Rodriguesmath/Pedaleira-digital/app/backend/README.md

# Backend




## Sobre

Serviço responsável por intermediar a comunicação entre o
[frontend](../frontend) e a pedaleira, publicando/assinando tópicos MQTT
consumidos pela [ESP32](../../firmware/esp32). Cuida de persistência de
presets, autenticação e demais regras de negócio da aplicação.

Ainda sem conteúdo.
