Rodriguesmath/Pedaleira-digital/firmware/esp32/README.md

# Firmware ESP32





## Sobre

Firmware responsável pela conectividade da pedaleira. Atua como ponte entre
a [STM32](../stm32), onde o áudio é processado, e uma aplicação externa
(mobile/desktop), via MQTT.

Recebe da aplicação as configurações de efeitos, equalização e demais
parâmetros, e repassa essas informações para a STM32 através da interface
de comunicação entre os dois microcontroladores.

## Status

Firmware ainda não iniciado.
