Rodriguesmath/Pedaleira-digital/docs/hardware/guia_esquematico_easyeda.md

# Guia Prático para Criação do Esquemático no EasyEDA Web





Este guia orienta passo a passo a montagem do esquemático elétrico do protótipo da **Pedaleira Digital** no [EasyEDA Web](https://easyeda.com/editor), utilizando componentes com encapsulamento **Through-Hole (DIP/THT)** ideais para montagem em protoboard e placa perfurada/ilhada, com seus respectivos códigos oficiais de catálogo **LCSC**.

---

## 1. Importação Direta do Arquivo JSON no EasyEDA Web (Recomendado)

O projeto disponibiliza o código-fonte nativo do esquemático em formato JSON padrão EasyEDA Standard em:
[`docs/hardware/pedaleira_digital_easyeda.json`](file:///home/rodrigues/Pedaleira-digital/docs/hardware/pedaleira_digital_easyeda.json).

Para abrir o esquemático pronto com 1 clique:
1. Acesse o editor web gratuito do EasyEDA: **[https://easyeda.com/editor](https://easyeda.com/editor)** (modo Standard).
2. No menu superior, clique em: **`File` $\to$ `Open` $\to$ `EasyEDA Source...`**
3. Clique em **`Load File`** e selecione o arquivo `pedaleira_digital_easyeda.json` (ou abra o arquivo de texto, copie todo o seu conteúdo JSON e cole na janela).
4. Clique no botão **`Apply`**.
5. O esquemático completo será aberto imediatamente, perfeitamente renderizado, com moldura técnica do IFPB, componentes Through-Hole, conexões elétricas, atributos LCSC para BOM e barramentos alinhados!

---

## 2. Visão Geral da Arquitetura do Esquemático

A folha única foi organizada em 8 seções lógicas:
1. **Alimentação Analógica & VREF (+4.5V)**: Jack DC 9V, diodo 1N4007, divisor de terra virtual de baixo ruído (100kΩ / 47µF). As dev boards são alimentadas via USB.
2. **Entrada de Áudio & Buffer Hi-Z (TL072 U1A)**: Jack P10 In, desacoplamento C1 (100nF), resistor de bias R3 (1MΩ) em VREF e seguidor de tensão.
3. **Filtro de Reconstrução & Saída de Áudio (TL072 U1B)**: Filtro passa-baixas Sallen-Key 22 kHz, capacitor de saída C5 (10µF), resistor anti-pop R6 (100kΩ) e Jack P10 Out.
4. **Módulo Codec CS4272**: Breakout 24-bit 48kHz com pinos analógicos à esquerda e barramento digital à direita.
5. **DSP Core (WeAct STM32H723VGT6)**: Modelado como conector header contendo apenas os pinos utilizados, mapeados livres de conflitos onboard.
6. **Conectividade IoT (ESP32 DevKit)**: Header com 4 pinos (5V, GND e barramento serial UART3 com o STM32).
7. **Interface do Usuário (4 Chaves MTS-102 & 4 LEDs)**: Chaves de alavanca com retenção lidas diretamente via pull-up interno da STM32 e LEDs acionados via resistores de 330Ω.
8. **Notas Técnicas de Montagem**: Regras de prototipagem para bancada/placa perfurada da disciplina.

---

## 3. Catálogo de Componentes Oficiais (Códigos LCSC)

Para adicionar qualquer componente no EasyEDA com o símbolo elétrico e o footprint de furos (Through-Hole) corretos:
1. Pressione **`Shift + B`** (ou clique na aba **`Library`** na barra lateral esquerda).
2. Cole o código **LCSC Part #** indicado na tabela abaixo no campo de busca e clique em **`Place`**:

| Categoria | Componente / Valor | Encapsulamento | Código LCSC (EasyEDA) | Função no Circuito |
| :--- | :--- | :---: | :---: | :--- |
| **CI Analógico** | **TL072CP** (Texas Instruments) | DIP-8 | **`C6955`** | Buffer de entrada Hi-Z e filtro ativo de saída |
| **Conector Áudio** | **Jack P10 Fêmea 6.35mm** | THT Horizontal | **`C2843477`** | Entrada de instrumento e saída de áudio |
| **Conector Alimentação**| **Jack DC P4 (2.1x5.5mm)** | THT (DC-005) | **`C136657`** | Conexão para fonte de pedal DC +9V |
| **Diodo Proteção** | **1N4007** | DO-41 (THT) | **`C2860`** | Proteção contra inversão de polaridade dos 9V |
| **Chaves Físicas** | **Chave Alavanca MTS-102** (SPDT) | Painel/THT | **`C318884`** | Comutação de Bypass/Ativação com retenção |
| **Headers STM32** | Barra Fêmea 1x20 (ou 2x20) 2.54mm | THT | **`C224345`** | Soquete de encaixe da Dev Board STM32 |
| **Headers ESP32** | Barra Fêmea 1x15 2.54mm (2 unidades) | THT | **`C224345`** | Soquete de encaixe da Dev Board ESP32 |
| **Headers Codec** | Barra Fêmea 1x10 2.54mm | THT | **`C224345`** | Conexão do módulo breakout CS4272 |
| **LEDs Difusos** | LED 5mm Vermelho | THT | **`C2286`** | Sinalização de Overdrive / Status |
| **LEDs Difusos** | LED 5mm Verde | THT | **`C2290`** | Sinalização de Equalizador Ativo |
| **Resistor** | **1 MΩ** 1/4W 1% filme metálico | THT Axial | **`C61685`** | Resistor de bias de alta impedância (Hi-Z) |
| **Resistor** | **100 kΩ** 1/4W 1% | THT Axial | **`C61678`** | Divisor do terra virtual (Vref) e anti-pop |
| **Resistor** | **1 kΩ** 1/4W 1% | THT Axial | **`C61671`** | Filtro de reconstrução de saída |
| **Resistor** | **330 Ω** 1/4W 1% | THT Axial | **`C61665`** | Limitador de corrente para os LEDs |
| **Resistor** | **4.7 kΩ** 1/4W 1% | THT Axial | **`C61674`** | Pull-up das linhas I2C (SCL/SDA) |
| **Capacitor** | **100 nF** (0.1µF) 50V cerâmico | THT Radial | **`C62649`** | Bloqueio DC de entrada e desacoplamento |
| **Capacitor** | **10 µF** 25V eletrolítico | THT Radial | **`C96985`** | Acoplamento AC de saída do buffer e filtro |
| **Capacitor** | **47 µF** 25V eletrolítico | THT Radial | **`C96991`** | Estabilização e filtragem do nó Vref (+4.5V) |
| **Capacitor** | **4.7 nF** (4700pF) 50V cerâmico | THT Radial | **`C62635`** | Capacitor 1 do filtro de reconstrução |
| **Capacitor** | **1.5 nF** (1500pF) 50V cerâmico | THT Radial | **`C62632`** | Capacitor 2 do filtro de reconstrução |

---

## 3. Estrutura do Esquemático em 5 Blocos Funcionais

Divida sua folha no EasyEDA em 5 áreas lógicas utilizando a ferramenta de texto (`T`) ou molduras retangulares:

```mermaid
flowchart TD
    subgraph S1["Bloco 1: Alimentação & Vref"]
        B1["Jack P4 (+9V) ➔ Diodo 1N4007 ➔ Linha +9V_RAW<br/>Divisor R1/R2 (100kΩ) + C3 (47µF) ➔ VREF (+4.5V)"]
    end

    subgraph S2["Bloco 2: Condicionamento de Entrada (Hi-Z)"]
        B2["Jack P10 In ➔ C1 (100nF) ➔ Não-Inversora (+) TL072<br/>Bias: R3 (1MΩ) ligado em VREF<br/>Feedback unitário: Saída ligada na Inversora (-)<br/>Saída ➔ C2 (10µF) ➔ NetLabel: ADC_IN_L"]
    end

    subgraph S3["Bloco 3: Filtro de Reconstrução de Saída"]
        B3["NetLabel: DAC_OUT_L ➔ Filtro R4/R5 (1kΩ) e C4/C6 (4.7nF/1.5nF)<br/>Buffer Seguidor TL072 ➔ C5 (10µF) ➔ R6 (100kΩ Anti-Pop)<br/>➔ Jack P10 Out"]
    end

    subgraph S4["Bloco 4: Núcleo Digital & Módulos"]
        B4["Header STM32H723 Dev Board (SAI1, I2C1, UART3, GPIOs)<br/>Header Codec CS4272 (I2S, I2C, Reset, Analógico)<br/>Header ESP32 DevKit (UART2, Wi-Fi)"]
    end

    subgraph S5["Bloco 5: Interface Física (Chaves & LEDs)"]
        B5["Chaves de Alavanca ligadas em PC0..PC3 ➔ GND<br/>LEDs com resistores 330Ω ligados em PE7, PE8, PE9, PE15 ➔ GND"]
    end
```

---

## 4. Tabela de Conexões por NetLabels (Pino a Pino)

Ao colocar um pino ou conector, basta ligar um pedaço de fio e anexar um **NetLabel** (tecla **`N`**) com exatamente o mesmo nome. O EasyEDA cuidará da conexão lógica:

### A. Barramento de Áudio e Controle (STM32 $\leftrightarrow$ Codec CS4272)
| NetLabel | Pino STM32H723 (WeAct) | Pino Módulo CS4272 | Função Elétrica |
| :--- | :---: | :---: | :--- |
| `SAI4_MCLK` | `PE0` (P1.4) | `MCLK` | Master Clock do Codec ($12.288\text{ MHz}$) |
| `SAI4_FS` | `PE4` (P2.5) | `LRCK` / `FS` | Frame Sync / Left-Right Clock ($48\text{ kHz}$) |
| `SAI4_SCK` | `PE5` (P2.6) | `SCLK` / `BCLK` | Serial Bit Clock ($3.072\text{ MHz}$) |
| `SAI4_SD_OUT` | `PE6` (P2.7) | `SDIN` | Dados de Áudio do STM32 para o DAC do Codec |
| `SAI4_SD_IN` | `PA0` (P2.17) | `SDOUT` | Dados de Áudio do ADC do Codec para o STM32 |
| `I2C1_SCL` | `PB8` (P1.6) | `SCL` | Linha I2C Clock (pull-up 4.7kΩ soldado na WeAct) |
| `I2C1_SDA` | `PB9` (P1.5) | `SDA` | Linha I2C Dados (pull-up 4.7kΩ soldado na WeAct) |
| `CODEC_RST` | `PD10` (P1.38) | `/RESET` | Reset de hardware ativo em LOW |

### B. Ponte Serial Inter-MCU (STM32 $\leftrightarrow$ ESP32)
| NetLabel | Pino STM32H723 (WeAct) | Pino ESP32 DevKit | Função Elétrica |
| :--- | :---: | :---: | :--- |
| `UART_TX_STM` | `PD8` (P1.40 - USART3_TX) | `GPIO16` (RX2) | Envio de telemetria e estado para o ESP32 |
| `UART_RX_STM` | `PD9` (P1.39 - USART3_RX) | `GPIO17` (TX2) | Recepção de parâmetros do App/MQTT pelo STM32 |

### C. Chaves com Retenção Mecânica e LEDs de Status
| NetLabel | Pino STM32 (WeAct) | Componente Físico | Conexão Externa |
| :--- | :---: | :--- | :--- |
| `SW_OVERDRIVE` | `PC0` (P2.11) | Chave Alavanca SW1 | Um terminal no pino `PC0`, outro no `GND` |
| `SW_EQ` | `PC1` (P2.12) | Chave Alavanca SW2 | Um terminal no pino `PC1`, outro no `GND` |
| `SW_DELAY` | `PC2` (P2.13) | Chave Alavanca SW3 | Um terminal no pino `PC2`, outro no `GND` |
| `SW_MUTE` | `PC3` (P2.14) | Chave Alavanca SW4 | Um terminal no pino `PC3`, outro no `GND` |
| `LED_OD_DRV` | `PE7` (P2.30) | Ânodo do LED Vermelho (via R 330Ω) | Cátodo do LED ligado no `GND` |
| `LED_EQ_DRV` | `PE8` (P2.31) | Ânodo do LED Verde (via R 330Ω) | Cátodo do LED ligado no `GND` |
| `LED_DLY_DRV` | `PE9` (P2.32) | Ânodo do LED Amarelo (via R 330Ω) | Cátodo do LED ligado no `GND` |
| `LED_STAT_DRV` | `PE15` (P2.38) | Ânodo do LED Azul (via R 330Ω) | Cátodo do LED ligado no `GND` |

---

## 5. Simulação Interativa no Navegador (Falstad)

Antes de soldar ou montar em bancada, você pode conferir o funcionamento elétrico do estágio analógico (guitarra $\to$ buffer Hi-Z TL072 $\to$ filtro de saída $\to$ osciloscópio) com apenas 1 clique no link abaixo:

🔗 **[Abrir Simulação do Buffer Hi-Z no Falstad Circuit Simulator](https://www.falstad.com/circuit/circuitjs.html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)**

Na simulação, você verá:
- A senoide limpa simulando o captador de guitarra na entrada ($300\text{ mV}_{\text{peak}}$ a $1\text{ kHz}$).
- A polarização estável de $V_{ref} = +4.5\text{V}$ com o divisor de $100\text{ k}\Omega$ e capacitor de desacoplamento.
- A saída isolada do buffer com nível estável pronto para o ADC do CS4272.
