Rodriguesmath/Pedaleira-digital/app/frontend/README.md

# Frontend



## Sobre

Aplicação de interface para configuração da pedaleira: seleção e
parametrização de efeitos, equalização e demais ajustes, comunicando-se com
o [backend](../backend) para refletir as mudanças na pedaleira em tempo
real.

Ainda sem conteúdo.
