Rodriguesmath/Pedaleira-digital/docs/hardware/schematic_preview.png

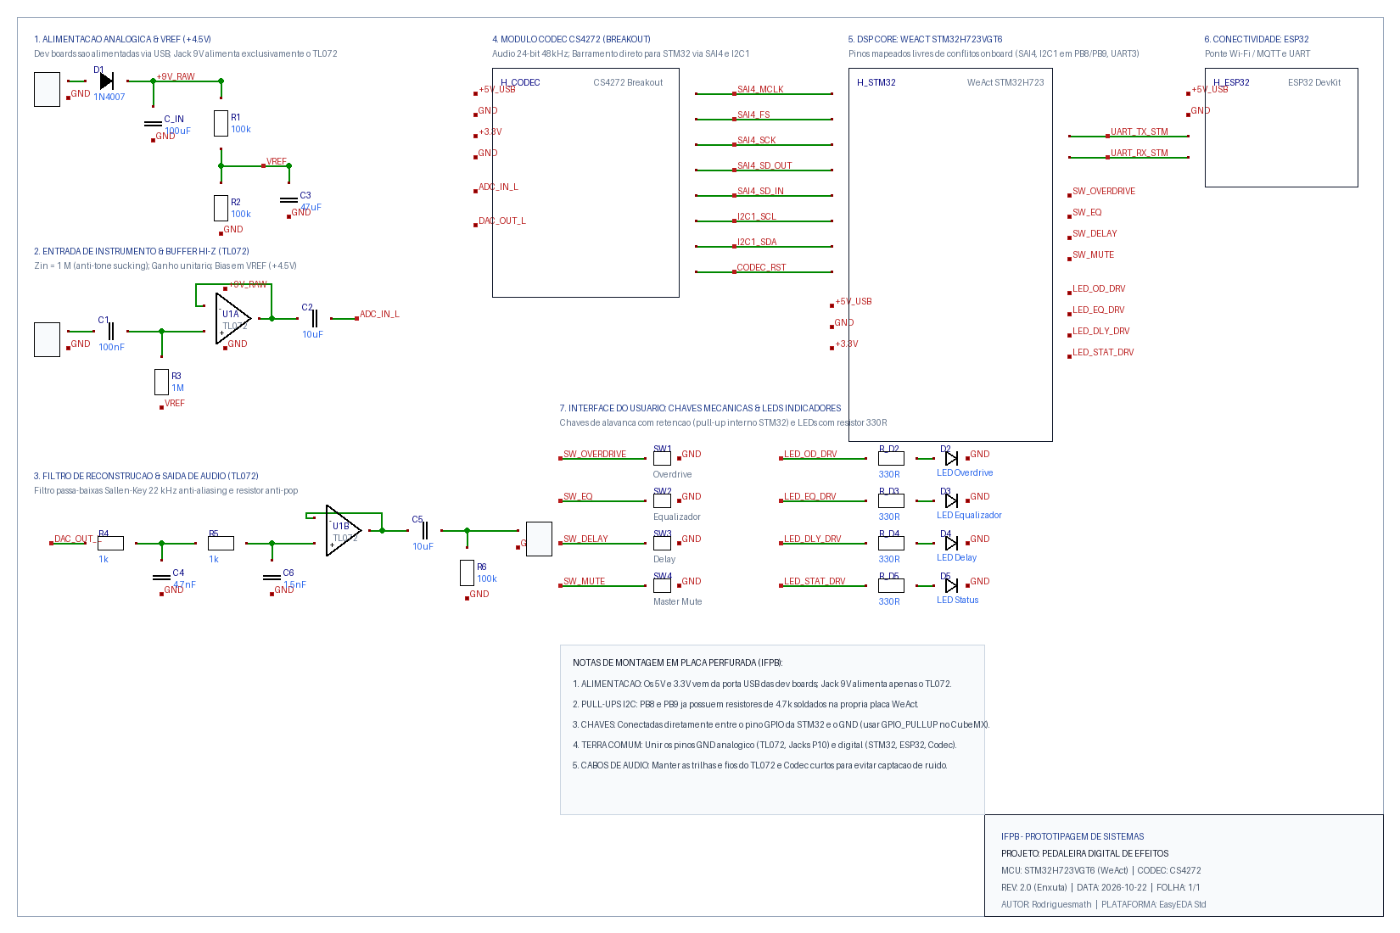
docs/hardware/schematic_preview.png
