Rodriguesmath/Pedaleira-digital/docs/components/README.md

# Documentação de Componentes



## Sobre

Datasheets e documentação técnica dos componentes utilizados no hardware
da pedaleira.

## Componentes

| Componente | Função | Arquivo |
|---|---|---|
| CS4272 | Codec de áudio | [CS4272_F2.pdf](./CS4272_F2.pdf) |
