Rodriguesmath/Pedaleira-digital/(list of files, drawings)

Other design files:
docs/hardware/pedaleira_digital_easyeda.json
