Rodriguesmath/Pedaleira-digital/firmware/stm32/Core/Inc/AssertTypes.h

/******************************************************************************/
/**
 * @file AssertTypes.h
 * @brief Redirecionamento de compatibilidade para AssertTypes.hpp.
 ******************************************************************************/
#ifndef _ASSERT_TYPES_H_
#define _ASSERT_TYPES_H_

#include "AssertTypes.hpp"

#endif /* _ASSERT_TYPES_H_ */
