Rodriguesmath/Pedaleira-digital/(commit log)

2026-08-09 chore: reorganiza firmware sob firmware/stm32 e firmware/esp32
2026-08-09 docs: adiciona README para firmware/stm32 e firmware/esp32
2026-08-09 docs: adiciona README para docs/code, docs/hardware e docs/components
2026-08-09 docs: adiciona guia de contribuicao (CONTRIBUTING.md)
2026-08-09 chore: ignora artefatos de build do ESP-IDF
2026-08-09 chore: adiciona templates de issue (bug report e feature request)
2026-08-09 chore: adiciona template de pull request
2026-09-03 docs: adiciona especificações do professor para orientar a prototipagem
2026-10-22 docs: conclude Milestone 1 (spec, scope, pinout, BOM and protocols)
    - Add formal requirements specification in docs/requisitos.md (RF01-RF07, RNF01-RNF06)
    - Add comprehensive scope definition and IFPB risk analysis in docs/escopo.md
    - Add hardware pinout, Hi-Z analog buffer circuit and BOM in docs/hardware/pinout_e_bom.md
    - Add binary UART and MQTT protocol specification in docs/code/protocolo_comunicacao.md
    - Update docs/README.md, docs/hardware/README.md and docs/code/README.md
    - Closes #4, #5, #8, #9 and closes Milestone 1
2026-10-22 docs: replace ASCII diagrams with Mermaid and update language to C++
    - Convert all architecture, state machine, circuit and evolution diagrams to Mermaid
    - Update language reference badges and text from C to C++17
    - Update CRC-8 implementation snippet to modern C++ inline constexpr style
    - Format packet framing as clean Markdown table
2026-10-22 docs: add comprehensive EasyEDA Web schematic guide and LCSC part numbers
    - Include step-by-step instructions for EasyEDA Web editor
    - Map exact LCSC part numbers for DIP/Through-Hole components
    - Provide NetLabel table for clean schematic interconnections
    - Embed interactive Falstad Circuit simulator link
2026-10-22 feat(hardware): add complete EasyEDA JSON schematic source file
    - 7 modular functional blocks covering Power/Vref, Hi-Z Buffer, Sallen-Key Filter, CS4272 Codec, STM32H723, ESP32 and User Switches/LEDs
    - Pre-wired connections with NetLabels, ground symbols and IC headers
    - Importable via EasyEDA Web (File -> Open -> EasyEDA Source...)
2026-10-25 feat(stm32): implementa arquitetura 100% C++17 e motor de processamento DSP DaisySP
    - Modela motor de DSP estatico sem alocacao dinamica em audio:
    - DspMath: soft-limiting cubico e funcoes matematicas inline
    - DspSvf: State Variable Filter trapezoidal bilineado (Andrew Simper)
    - DspOverdrive: saturacao valvulada e tone filter
    - DspEqualizer: equalizador parametrico de 3 bandas (100Hz, 1kHz, 4kHz)
    - DspDelay: linha de delay com interpolacao fracionaria e buffer circular
    - DspCrossfade: transicoes com rampa linear livre de clicks
    - DspEngine: pipeline mestre de audio estéreo
    - Encapsula perifericos de hardware em classes C++17:
    - Bsp: classe estatica (clocks 550MHz, caches L1,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
2026-10-25 test(stm32): adiciona suíte automatizada de testes e Quality Gate determinístico
    - Valida estilo de chaves Allman estrito em todas as classes e metodos
    - Garante ausencia de caracteres TAB (100% 4 espacos)
    - Valida conformidade com 100% 7-bit ASCII puro (zero acentos em comentarios)
    - Proibe blocos de controle de uma linha sem delimitacao explicita por chaves
    - Checa presenca e ordenacao das secoes canônicas Doxygen do padrao ASSERT
    - Valida vetores de teste formais de CRC-8 CCITT do protocolo serial Inter-MCU
    - Verifica compilacao multiobjeto estrita com g++ -std=c++17 -Wall -Wextra -Werror
    - Adiciona teste de ordem alfabetica estrita da autoria da equipe de engenharia
2026-10-25 docs: padroniza autoria da equipe em ordem alfabética e referência das normas ASSERT
    - Registra no README e escopo.md os membros da equipe em ordem alfabetica:
    Arthur Ramalho, Isabelle Lavínia, João Paulo e Rodrigues Matheus
    - Diferencia formalmente a equipe do projeto das normas do manual Assert Capacita v1.0
    - Mantem consistencia entre documentacao Markdown e headers de firmware
2026-10-25 docs: adiciona plano experimental de testes de bancada por etapa para os efeitos DSP
    - Detalha procedimento operacional padrao (POP) em 6 etapas:
    - Etapa 0: Loopback transparente e medicao de ganho/latencia
    - Etapa 1: Overdrive com ceifamento cubico e FFT de harmonicos impares
    - Etapa 2: Equalizador 3 bandas (Low-Shelf 100Hz, Mid-Peak 1kHz, High-Shelf 4kHz)
    - Etapa 3: Delay circular, precisao temporal e malha de feedback
    - Etapa 4: Master crossfade anti-pop com rampa continua de 10ms
    - Etapa 5: Cadeia completa com instrumento real e medicao de carga DWT
    - Inclui folha de homologacao formal com criterios objetivos PASS/FAIL
    - Padroniza autoria em ordem alfabetica (Arthur, Isabelle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
2026-10-25 docs: substitui diagramas ASCII por Mermaid em todo o plano de testes de bancada
    - Substitui diagrama geral de bancada por Mermaid flowchart
    - Adiciona diagramas de fluxo Mermaid dedicados para cada uma das etapas:
    - Etapa 0: Loopback e medicao osciloscopio
    - Etapa 1: Cadeia interna de overdrive e saturacao SoftLimit
    - Etapa 2: Topologia paralela do equalizador parametrico 3 bandas
    - Etapa 3: Buffer circular de delay, interpolacao e malha de feedback
    - Etapa 4: Gerador de slew e crossfade anti-pop de potencia constante
    - Etapa 5: Pipeline completo integrado e medicao de ciclos DWT
2026-10-25 fix(docs): corrige sintaxe Mermaid nos diagramas do plano de testes
    - Corrige setas bidirecionais e remove aspas internas nos rotulos de conexao
    - Garante renderizacao 100% compativel com o visualizador nativo do GitHub
