Rodriguesmath/Pedaleira-digital/(notices)

Notices in the files:
README.md:
License: MIT
